goakley/yamaha-pedal-unit/(commit log)

2025-07-11 Finish wire protocol
2025-07-11 Add assembly image
2025-07-11 Provide example connector
